VoltixTeam/Voltix_SolarShield/README.md

# Voltix Solar Shield



The solar shield plugs into the headers of the [Voltix board](https://github.com/VoltixTeam/Voltix_Board). It has four small solar cells and a sliding switch to selectively switch on one, three, or all solar cells. This way you can experiment and see which configuration works best under the given light conditions.

Latest design files:

 - [Schematics](https://voltix-docs.vercel.app/artifacts/solar_shield/latest/schematics.pdf)
 - [Layout](https://voltix-docs.vercel.app/artifacts/solar_shield/latest/pcb.pdf)
 - [Rendering](https://voltix-docs.vercel.app/artifacts/solar_shield/latest/3drendering.png "Voltix solar shield")

Rendering Voltix solar shield
