VoltixTeam/Voltix_SolarShield/kicad/voltix-solar-shield.kicad_pcb

## KiCad design kicad/voltix-solar-shield.kicad_pcb (2024-06-26)

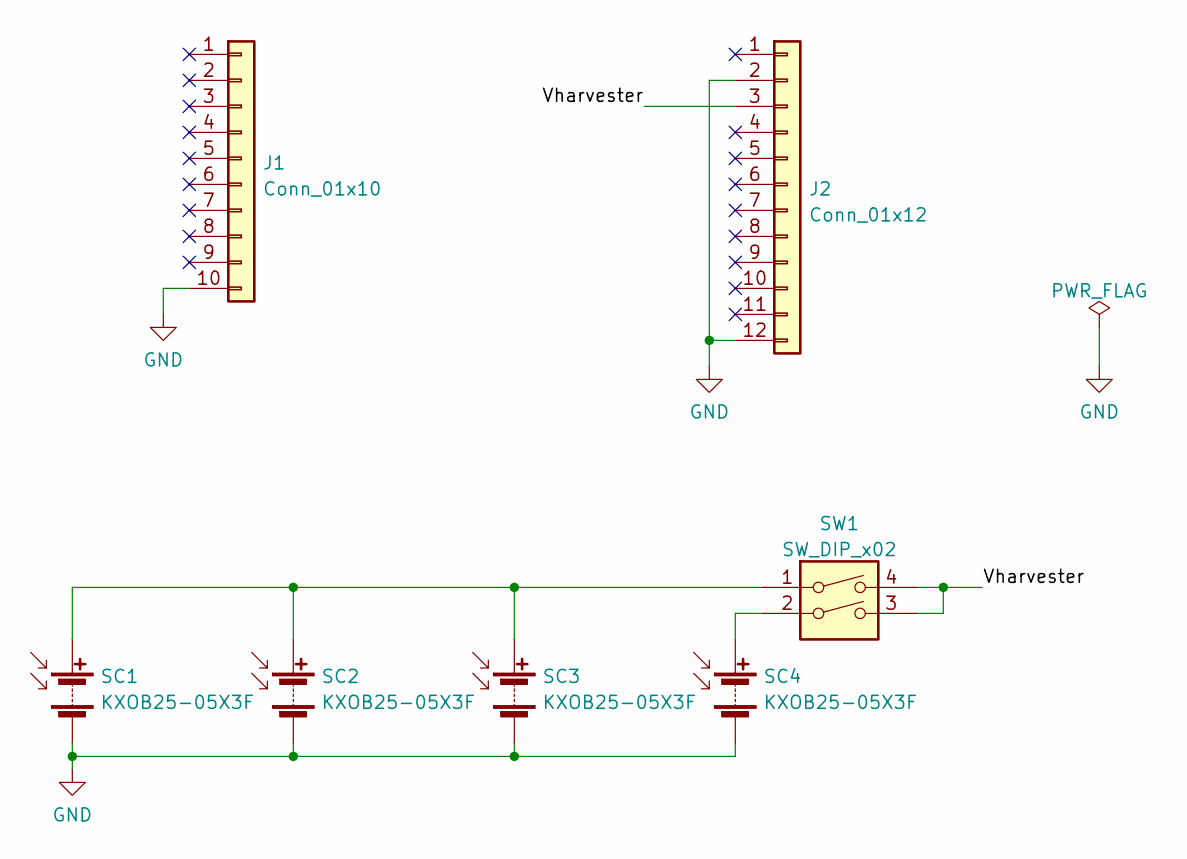
[picture p1: schematic voltix-solar-shield.kicad_sch]

Parts:
J1: Conn_01x10; PinHeader_1x10_P2.54mm_Vertical; MPN PH1-10-UA
J2: Conn_01x12; PinHeader_1x12_P2.54mm_Vertical; MPN PH1-12-UA
SC1, SC2, SC3, SC4: KXOB25-05X3F; AS_KXOB25_23x08; MPN KXOB25-05X3F-TR
SW1: SW_DIP_x02; TE_1825058-1; MPN ADE02S04

Connections:
/Vharvester: J2.3, SW1.3, SW1.4
GND: J1.10, J2.2, J2.12, SC1.2 (-), SC2.2 (-), SC3.2 (-), SC4.2 (-)
unnamed: SC1.1 (+), SC2.1 (+), SC3.1 (+), SW1.1
unnamed: SC4.1 (+), SW1.2

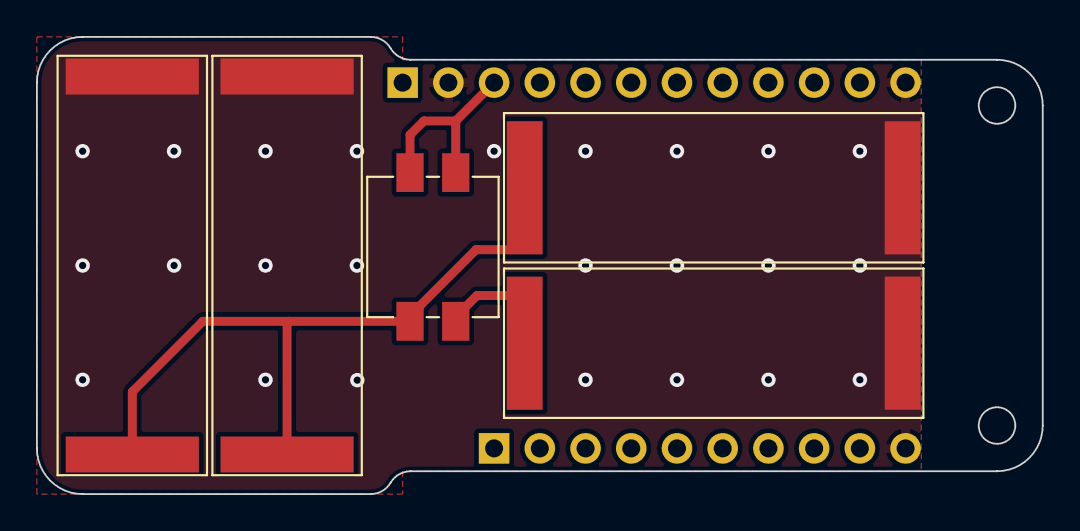
[picture p2: board voltix-solar-shield.kicad_pcb from above]

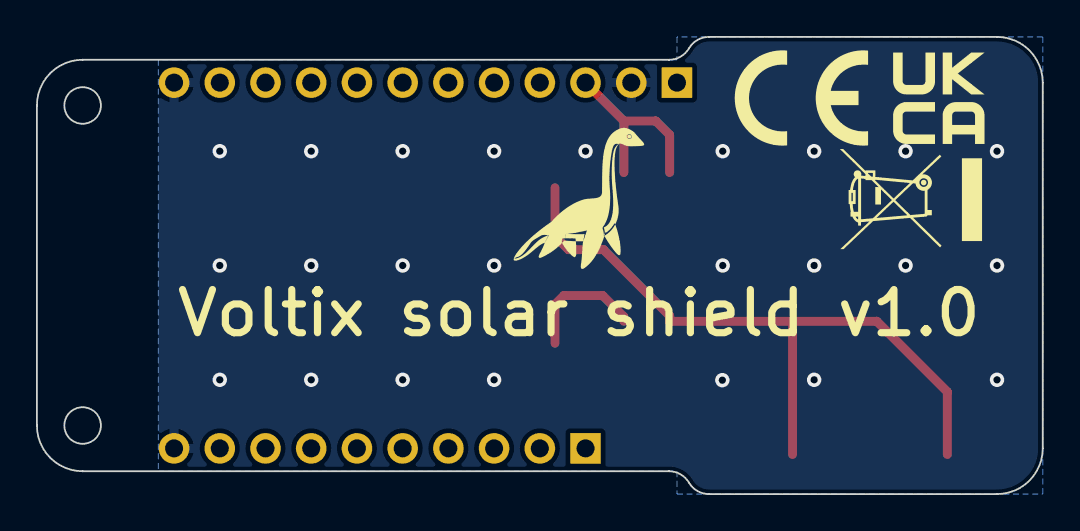
[picture p3: board voltix-solar-shield.kicad_pcb from below]

Board: 2 copper layers, 55.9 x 25.4 mm, 7 parts (2 on the bottom side), 4 nets.
